beadon/shredlight-mounts/docs/reference/front-with-ruler.jpg

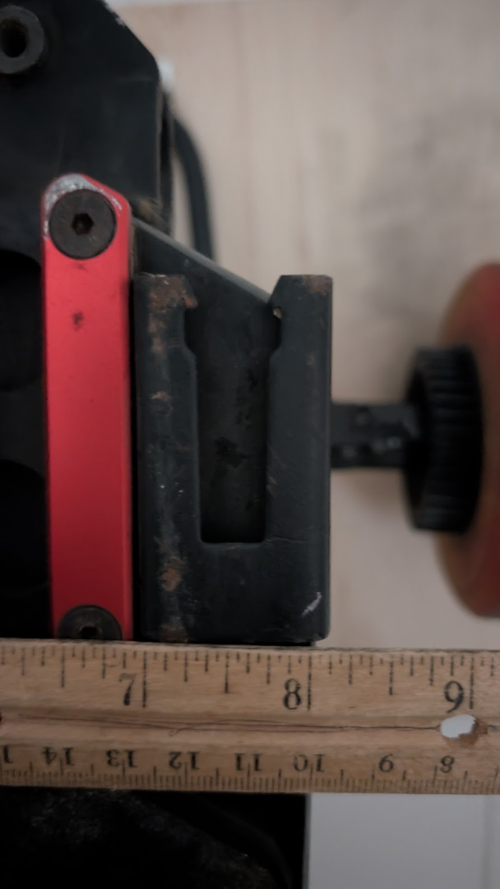
docs/reference/front-with-ruler.jpg
