beadon/shredlight-mounts/docs/reference/side-depth.jpg

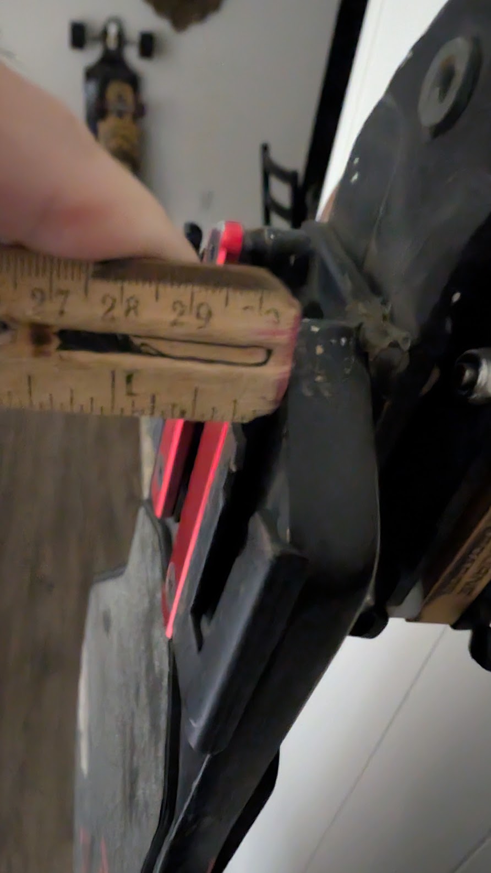
docs/reference/side-depth.jpg
