beadon/shredlight-mounts/docs/reference/truck/oblique-rake-with-ruler.jpg

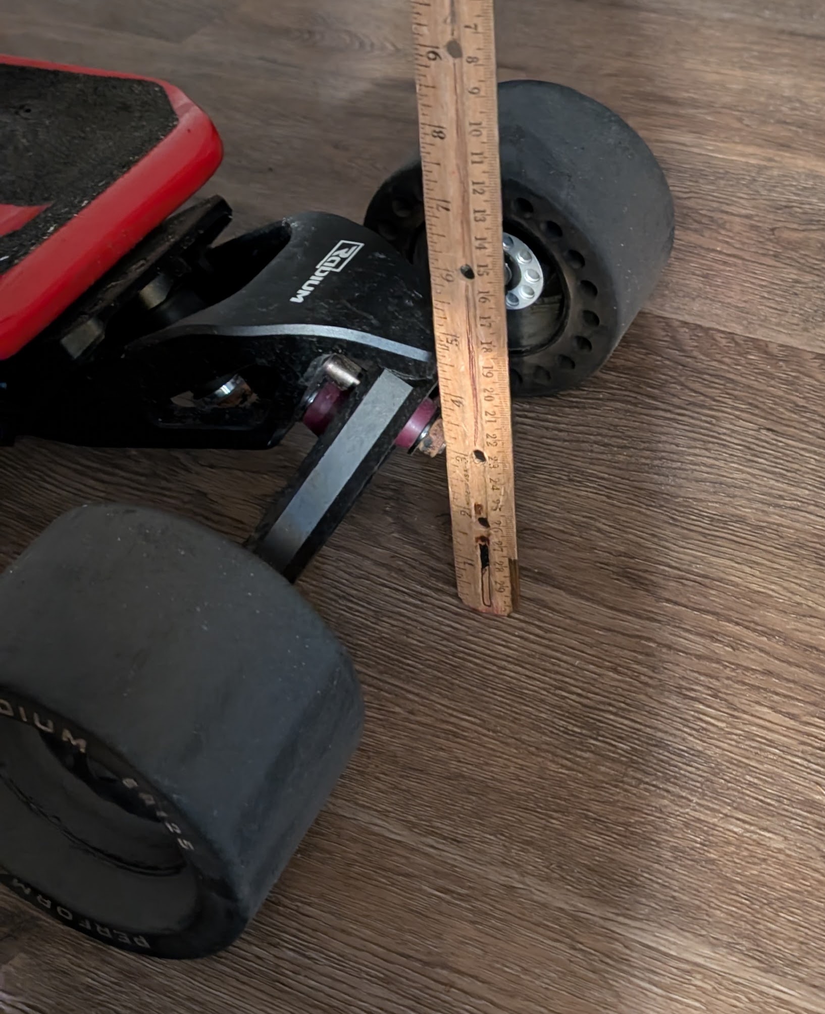
docs/reference/truck/oblique-rake-with-ruler.jpg
