beadon/shredlight-mounts/docs/reference/truck/rake-closeup.jpg

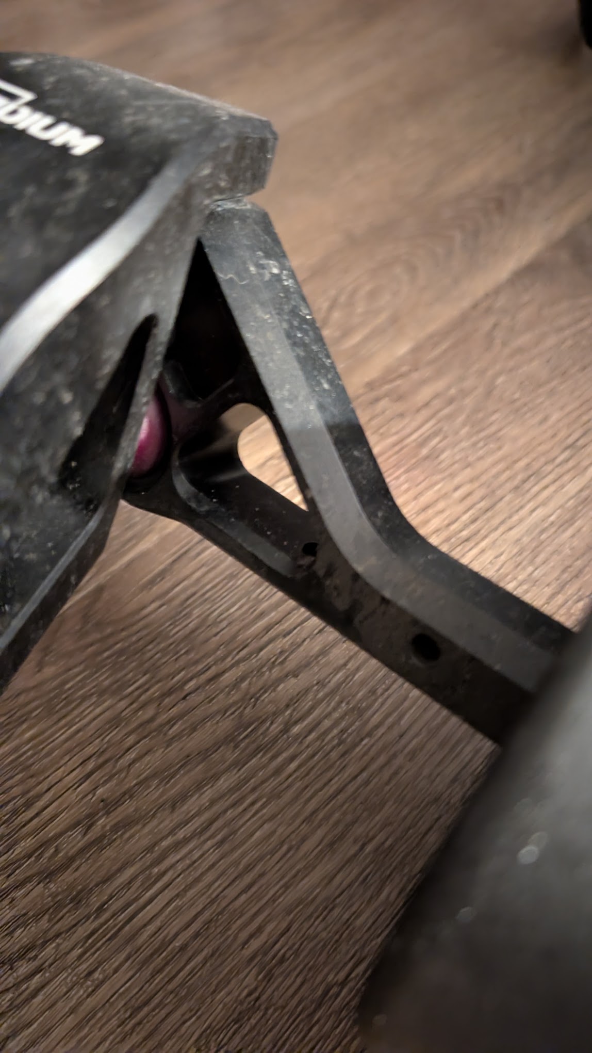
docs/reference/truck/rake-closeup.jpg
