beadon/shredlight-mounts/docs/reference/truck/side-rake-with-ruler.jpg

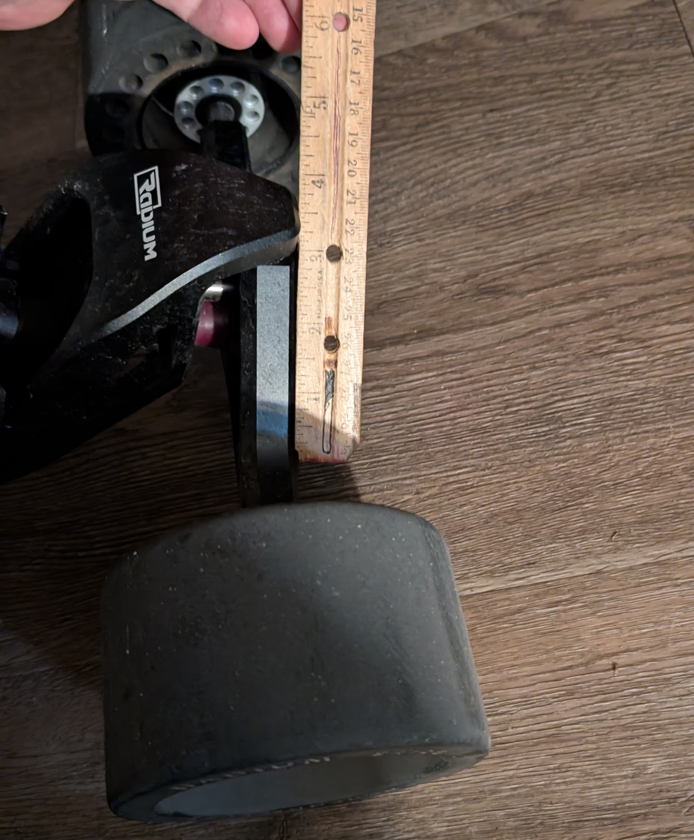
docs/reference/truck/side-rake-with-ruler.jpg
