beadon/shredlight-mounts/docs/reference/truck/top-with-ruler.jpg

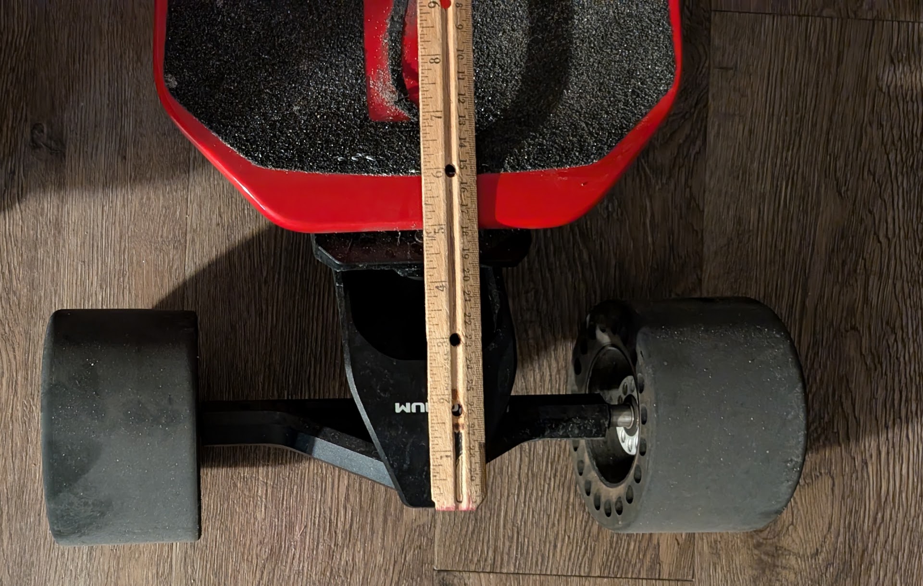
docs/reference/truck/top-with-ruler.jpg
