beadon/shredlight-mounts/docs/truck_views.png

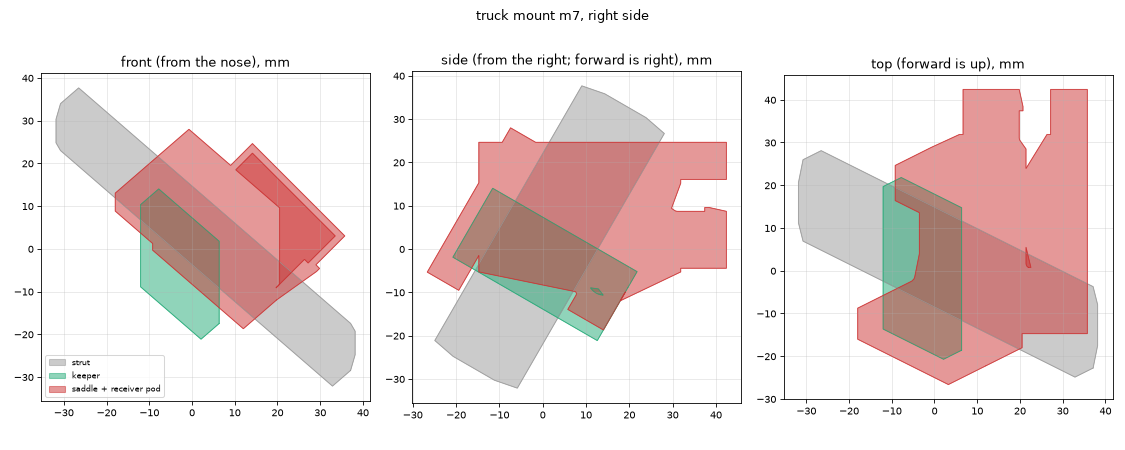
docs/truck_views.png
