beadon/shredlight-mounts/out/truck/assembly_m7_left_keeper.stl

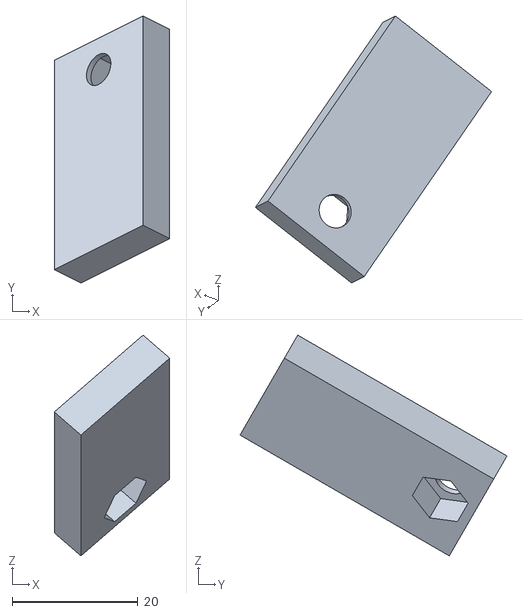
[picture p11: CAD file, 2026-10-17]
out/truck/assembly_m7_left_keeper.stl
18.4 x 42.5 x 35.2
