beadon/shredlight-mounts/out/truck/assembly_m7_right_saddle.stl

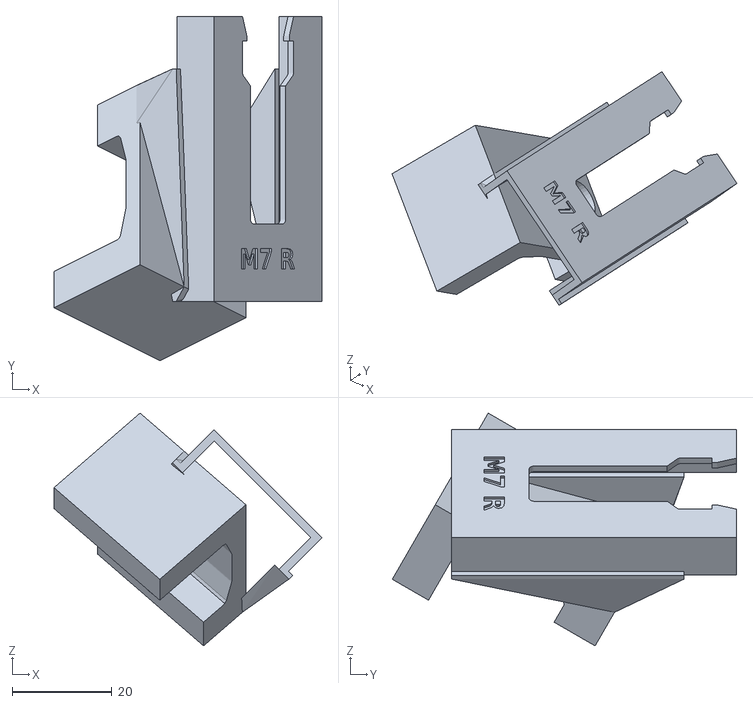
[picture p12: CAD file, 2026-10-17]
out/truck/assembly_m7_right_saddle.stl
53.7 x 69.1 x 46.7
