beadon/shredlight-mounts/out/truck/assembly_m7_hanger_schematic.stl

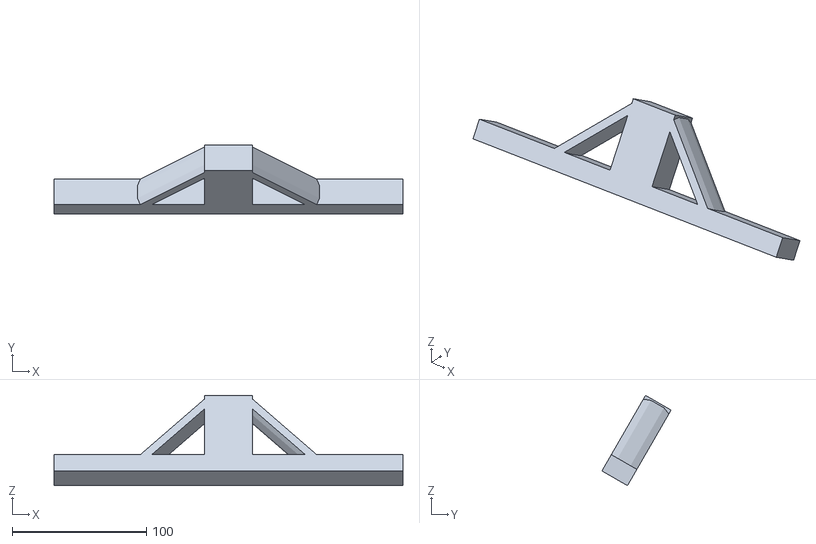
[picture p13: CAD file, 2026-10-17]
out/truck/assembly_m7_hanger_schematic.stl
260.0 x 51.6 x 67.3
