beadon/shredlight-mounts/out/truck/assembly_m7.obj

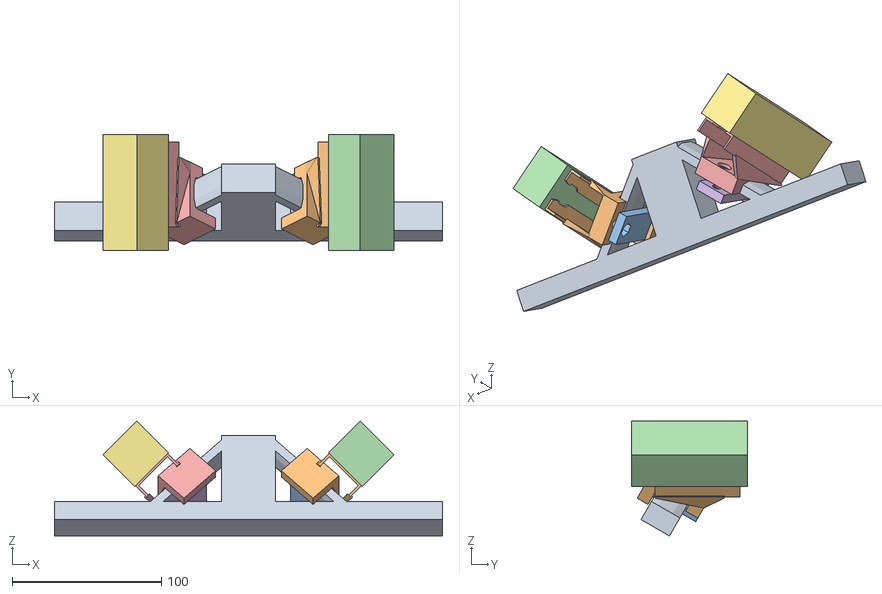
[picture p14: CAD file, 2026-10-17]
out/truck/assembly_m7.obj
260.0 x 78.0 x 77.0
hanger_schematic
right_saddle
right_keeper
right_light_placeholder
left_saddle
left_keeper
left_light_placeholder
