beadon/shredlight-mounts/out/shredlight_mount_right_v7.stl

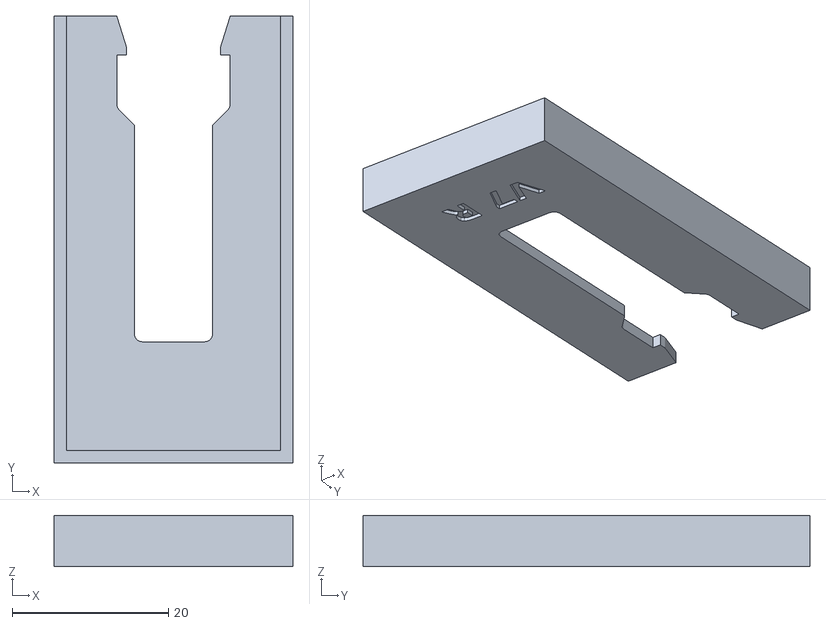
[picture p15: CAD file, 2026-10-17]
out/shredlight_mount_right_v7.stl
30.6 x 57.2 x 6.55
