beadon/shredlight-mounts/out/truck/truck_mount_right_m7_saddle.stl

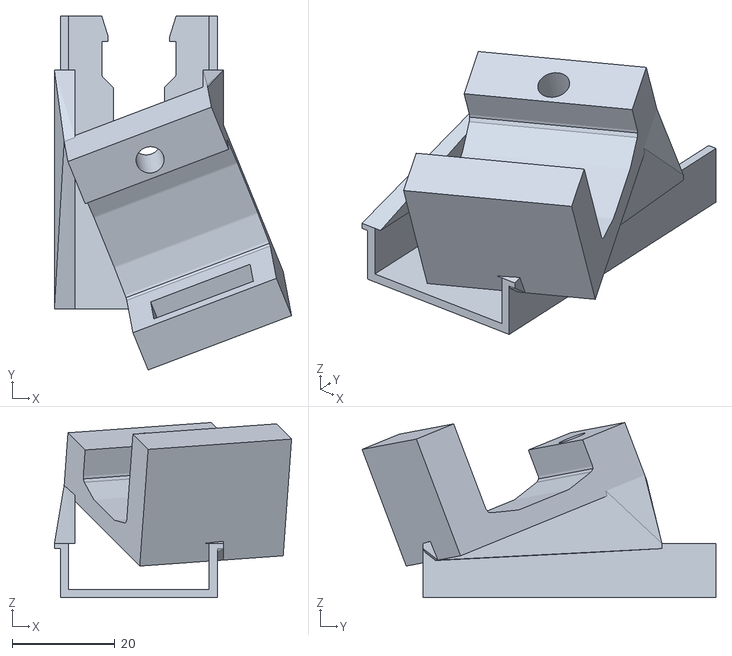
[picture p16: CAD file, 2026-10-17]
out/truck/truck_mount_right_m7_saddle.stl
46.3 x 69.1 x 34.2
