beadon/shredlight-mounts/out/truck/truck_mount_left_m7_keeper.stl

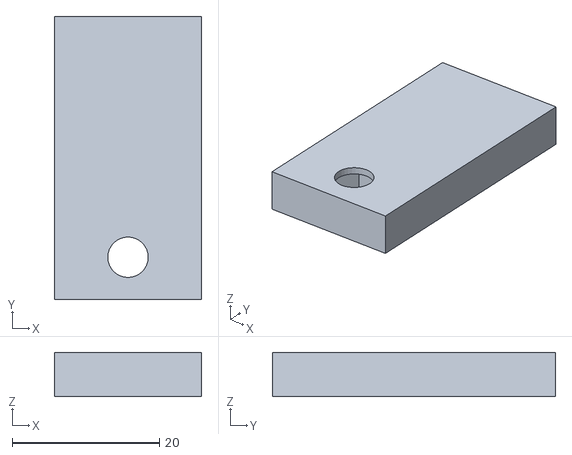
[picture p17: CAD file, 2026-10-17]
out/truck/truck_mount_left_m7_keeper.stl
20.0 x 38.5 x 6.00
