beadon/shredlight-mounts/out/truck/truck_mount_left_m6_saddle.stl

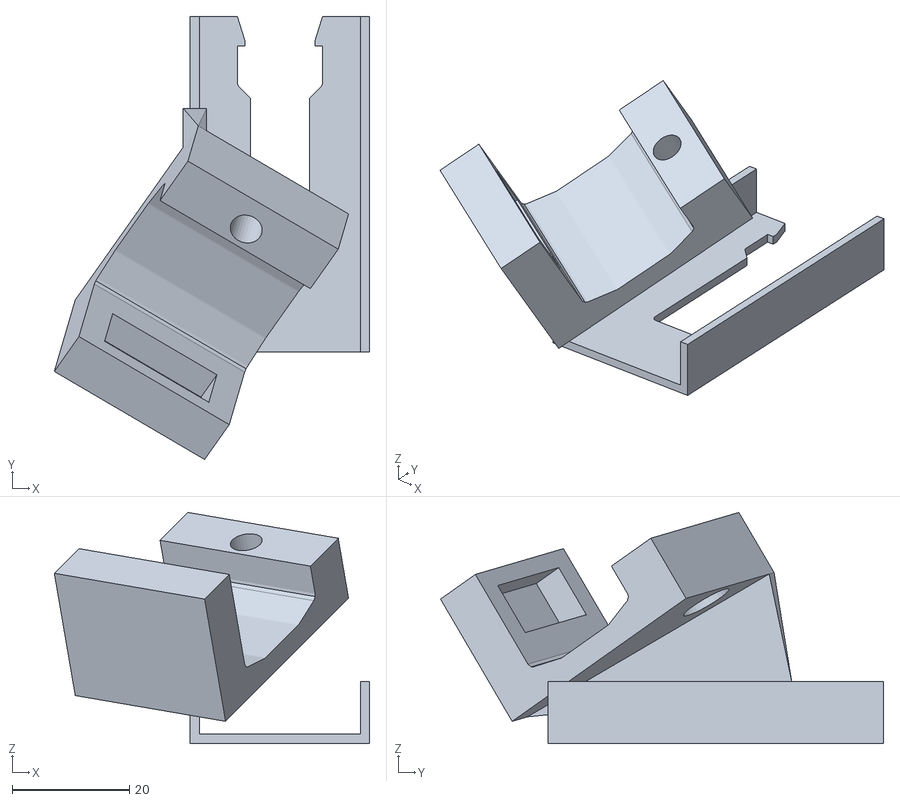
[picture p18: CAD file, 2026-10-17]
out/truck/truck_mount_left_m6_saddle.stl
53.7 x 75.5 x 39.4
