beadon/shredlight-mounts/out/shredlight_mount_left_v3.stl

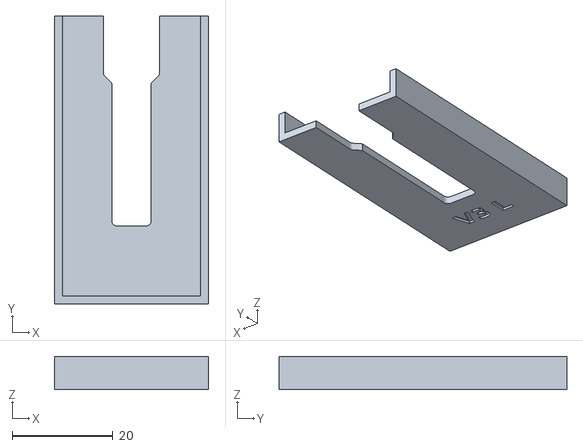
[picture p19: CAD file, 2026-10-17, an earlier design]
out/shredlight_mount_left_v3.stl
30.6 x 57.2 x 6.55
