beadon/shredlight-mounts/out/shredlight_mount_left_v1.stl

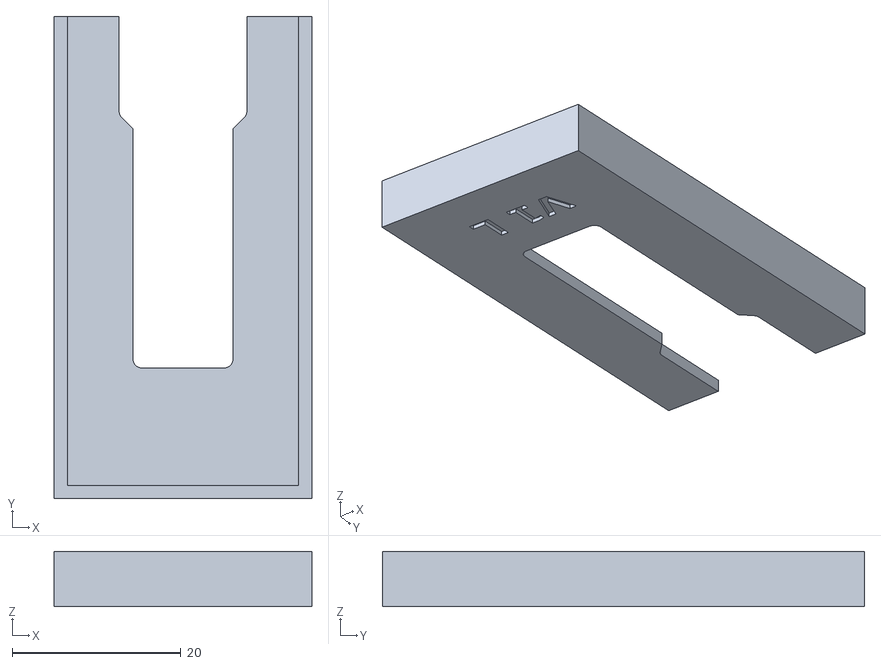
[picture p20: CAD file, 2026-10-17, an earlier design]
out/shredlight_mount_left_v1.stl
30.6 x 57.2 x 6.55
