beadon/shredlight-mounts/(list of files, cad)

Other CAD files:
out/truck/assembly_m7_right_keeper.stl
out/truck/assembly_m7_left_saddle.stl
out/shredlight_mount_left_v7.stl
out/truck/truck_mount_left_m7_saddle.stl
out/truck/truck_mount_right_m7_keeper.stl
out/truck/truck_mount_right_m6_saddle.stl
out/shredlight_mount_right_v6.stl
out/shredlight_mount_left_v6.stl
out/shredlight_mount_left_v2.stl
out/shredlight_mount_left_v4.stl
out/shredlight_mount_left_v5.stl
out/shredlight_mount_right_v1.stl
out/shredlight_mount_right_v2.stl
out/shredlight_mount_right_v3.stl
out/shredlight_mount_right_v4.stl
out/shredlight_mount_right_v5.stl
