beadon/shredlight-mounts/(commit log)

2026-10-17 Parametric Shredlights receiver mount with fit-test versions v1-v4
    Left and mirrored right receivers copied from the stock sheet-metal
    bracket, measured from photos. Includes engraved version labels,
    generated STLs, slice previews and GPL-3.0 license.
    [shredlight_mount_left_v1.stl, shredlight_mount_left_v2.stl, shredlight_mount_left_v3.stl, shredlight_mount_left_v4.stl, shredlight_mount_right_v1.stl, shredlight_mount_right_v2.stl, shredlight_mount_right_v3.stl, shredlight_mount_right_v4.stl]
2026-10-17 Add v5: widen upper slot to 14.5 mm to stop the lip spreading
    v2's upper slot spread about 1 mm when the SL-300 was inserted, so v5
    takes the measured spread plus ~0.4 mm clearance. The lower slot stays
    at 10 mm.
    [shredlight_mount_left_v5.stl, shredlight_mount_right_v5.stl]
2026-10-17 Mark v5 as the winning fit: no deformation on insert
    v4 measured the same ~1 mm spread as v2, so the SL-300 upper tongue is
    about 14 mm; v5's 14.5 mm upper slot inserts with no deformation.
2026-10-17 Add v6 (v5 fit + lead-in and step fillets); export STLs face-down
    v6 keeps v5's 14.5/10 mm slot and adds a 0.5 mm lead-in at the slot
    entrance and 1.5 mm fillets on the step edges. v1-v5 geometry is
    unchanged (zero difference volume). STLs are now exported lip-down on
    z=0 so they slice without rotating.
    [shredlight_mount_left_v1.stl, shredlight_mount_left_v2.stl, shredlight_mount_left_v3.stl, shredlight_mount_left_v4.stl, shredlight_mount_left_v5.stl, shredlight_mount_left_v6.stl, shredlight_mount_right_v1.stl, shredlight_mount_right_v2.stl]
2026-10-17 Record v6 test: holds the light less well; v5 remains the winner
    The rounded lead-in likely removed the sharp top-of-slot corners the
    SL-300's clamp catches on.
2026-10-17 Add v7: v5 plus snap-fit barbs copied from the stock part
    Barbs at the top of each slot arm: 12 mm tip-to-tip (caliper-measured),
    a ramp over the top 4 mm, a 1 mm tip flat and a flat latching ledge 5 mm
    below the top edge. Barbs are added after the slot rounding so the ledge
    stays sharp. v1-v6 geometry is unchanged.
    [shredlight_mount_left_v7.stl, shredlight_mount_right_v7.stl]
2026-10-17 Add truck mount m1: two-part strut clamp for the Radium Mach One S
    The saddle drops over the hanger strut and carries a 45-degree wedge
    and a v7 receiver pod, so the light sits level and points forward. A
    flat keeper slides through the window under the strut. Two M4 screws
    with nyloc nuts clamp the parts through a 1 mm liner gap. Left and
    right are mirrored. Includes print-oriented and assembly STLs, a
    three-view preview, and the truck reference photos.
    [reference_strut_right.stl, truck_mount_left_m1_assembly_keeper.stl, truck_mount_left_m1_assembly_saddle.stl, truck_mount_left_m1_keeper.stl, truck_mount_left_m1_saddle.stl, truck_mount_right_m1_assembly_keeper.stl, truck_mount_right_m1_assembly_saddle.stl, truck_mount_right_m1_keeper.stl]
2026-10-17 Truck mount m2: open receiver, so grit falls through and air flows behind the light
    The light hangs on the barbs, so the receiver keeps only v7's lip plate
    and side rails. The bottom wall and back pad are gone, and the solid
    wedge becomes two webs outside the rails. Behind the lip there is
    nothing but the clamp itself, so the pocket is open top, bottom and
    back. The lip and barbs are identical to v7. The saddle drops from
    38.3 to 19.3 cm^3.
    [truck_mount_left_m1_assembly_saddle.stl, truck_mount_left_m1_saddle.stl, truck_mount_left_m2_assembly_keeper.stl, truck_mount_left_m2_assembly_saddle.stl, truck_mount_left_m2_keeper.stl, truck_mount_left_m2_saddle.stl, truck_mount_right_m1_assembly_saddle.stl, truck_mount_right_m1_saddle.stl]
2026-10-17 README: saddle print orientation and tree-support settings
2026-10-17 Truck mount: one assembly with both mounts on a schematic hanger
    The per-side assembly files mirrored each mount about its own strut, so
    in Blender the two struts crossed in an X. The new assembly_m2_* files
    place both mounts on a schematic hanger whose struts meet in a ^, with
    the left side mirrored across the board centreline. Only the strut
    cross-section is to measurement. The printed parts are unchanged.
    [assembly_m2_hanger_schematic.stl, assembly_m2_left_keeper.stl, assembly_m2_left_saddle.stl, assembly_m2_right_keeper.stl, assembly_m2_right_saddle.stl, reference_strut_right.stl, truck_mount_left_m2_assembly_keeper.stl, truck_mount_left_m2_assembly_saddle.stl]
2026-10-17 Truck mount m3: strut is 22.5 mm across, not 32; M4x30 screws
    The 32 mm strut reading was taken vertically across the slanted strut.
    Measured square to its length it is 22-23 mm, which also fits the 65 mm
    hanger height. m2's saddle would have sat ~9 mm high, more than the 3 mm
    of clamp take-up, so it could not have clamped. The clamp stack shrinks,
    so the screws go from M4x40 to M4x30. The schematic hanger is now capped
    at the measured 65 mm.
    [assembly_m2_hanger_schematic.stl, assembly_m2_left_saddle.stl, assembly_m2_right_saddle.stl, assembly_m3_hanger_schematic.stl, assembly_m3_left_keeper.stl, assembly_m3_left_saddle.stl, assembly_m3_right_keeper.stl, assembly_m3_right_saddle.stl]
2026-10-17 Truck assembly: one OBJ with named, coloured parts for Blender
    [assembly_m3.obj]
2026-10-17 Truck mount m4: strut is ~9 mm across and 22 mm deep; M4x20
    From the ruler photo and Blender comparison, the strut leg is ~9 mm
    across in the hanger's plane, and 22 mm is its front-to-back depth.
    That matches the original description. The clamp stack shrinks to
    21 mm, so the screws become M4x20. The chamfers are modelled shallow,
    because their depth isn't measured. The saddle grows to 30 mm along
    the strut, so its front cheek is wider than the open channel behind the
    lip and the webs stay attached (at 20 mm the part split in two). The
    receiver is raised 10 mm to keep its ground clearance.
    [assembly_m3.obj, assembly_m3_hanger_schematic.stl, assembly_m3_left_saddle.stl, assembly_m3_right_saddle.stl, assembly_m4.obj, assembly_m4_hanger_schematic.stl, assembly_m4_left_keeper.stl, assembly_m4_left_saddle.stl]
2026-10-17 Truck mount m5: receiver 10 mm lower and clear of the screw access
    The receiver top is level with the strut's top face again (it was 10 mm
    higher in m4), so it sits closer to the truck. POD_FORWARD adds 10 mm
    of standoff, so the hex-key path to the front screw no longer cuts
    through the webs (48.7 mm^3 removed in m4, now none). Because the plate
    leans forward, lowering the receiver brought it back 10 mm, so its face
    sits where m4's did. A further 10 mm forward was tried and rejected: it
    thinned the webs from 109 to 92 mm^2 and lengthened the lever arm. The
    clamp and screw holes are unchanged.
    [assembly_m4.obj, assembly_m4_left_saddle.stl, assembly_m4_right_saddle.stl, assembly_m5.obj, assembly_m5_hanger_schematic.stl, assembly_m5_left_keeper.stl, assembly_m5_left_saddle.stl, assembly_m5_right_keeper.stl]
2026-10-17 Truck mount m6: face-up platform, hook plus one M5 screw through the slot
    The light lies on top of the receiver with its lens at the slot's open
    end, so the receiver is now a face-up platform, level fore-aft, with the
    slot opening toward the nose. It is rolled 45 degrees outboard to sit
    low over the clamp: the smallest roll that passes every check (below
    about 35 degrees the screw path clips the lip, and 35-40 degrees comes
    within 2 mm of the schematic hanger).
    The rear screw is replaced by a hook. The saddle's rear arm has a pocket
    whose lip catches the keeper's rear end, and the keeper slides in
    through the window from the front. One M5x20 screw at the front is
    fitted and tightened throug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
    [assembly_m5.obj, assembly_m5_left_keeper.stl, assembly_m5_left_saddle.stl, assembly_m5_right_keeper.stl, assembly_m5_right_saddle.stl, assembly_m6.obj, assembly_m6_hanger_schematic.stl, assembly_m6_left_keeper.stl]
2026-10-17 README: m6 print and level-check notes
2026-10-17 Record confirmed hanger tilt and beam direction
    The 45-degree plate tilt and strut angle, and the SL-300's beam running
    parallel to its mounting face, are confirmed, so m6's beam is level and
    straight ahead.
2026-10-17 README: status, how the light attaches, truck print notes, units
    The intro now describes the light lying on the receiver and sliding in
    from the slot's open end. Adds a status line (v7 final, m6 left side
    printing), truck-mount print notes, which script uses inches and which
    millimetres, a link to the silhouette drawing, and the m6 test-fit
    checklist. Preview images regenerated.
2026-10-17 Truck mount m7: platform tipped 15 degrees nose-down
    The m6 test fit, held in place on the strut, aimed about 15 degrees high.
    Add PITCH_DOWN and draw the beam against level in the side render.
    [assembly_m6.obj, assembly_m6_left_saddle.stl, assembly_m6_right_saddle.stl, assembly_m7.obj, assembly_m7_hanger_schematic.stl, assembly_m7_left_keeper.stl, assembly_m7_left_saddle.stl, assembly_m7_right_keeper.stl]
2026-10-17 Hanger tilt is 30 degrees (Radium's R6 truck angle)
    The m6 test fit aimed ~15 degrees high, which is the 45 -> 30 degree tilt
    difference. TILT = 30 with PITCH_DOWN = 0 gives the same m7 saddle as
    TILT = 45 with PITCH_DOWN = 15; only the assembly preview moves.
    [assembly_m7.obj, assembly_m7_hanger_schematic.stl, assembly_m7_left_keeper.stl, assembly_m7_left_saddle.stl, assembly_m7_right_keeper.stl, assembly_m7_right_saddle.stl, truck_mount_left_m7_saddle.stl, truck_mount_right_m7_saddle.stl]
